shenxiaofeng2019/rail-traffic_prj/Code/版本说明.txt

20200716：上海10台安装
20200803：上海6台安装
20200814：演示代码Z轴演示归零
20200723：演示代码Z轴演示
20200821：演示代码三轴演示
20200915：演示代码增加通讯应答及等待超时机制
