shenxiaofeng2019/rail-traffic_prj/轨交异常数据.docx

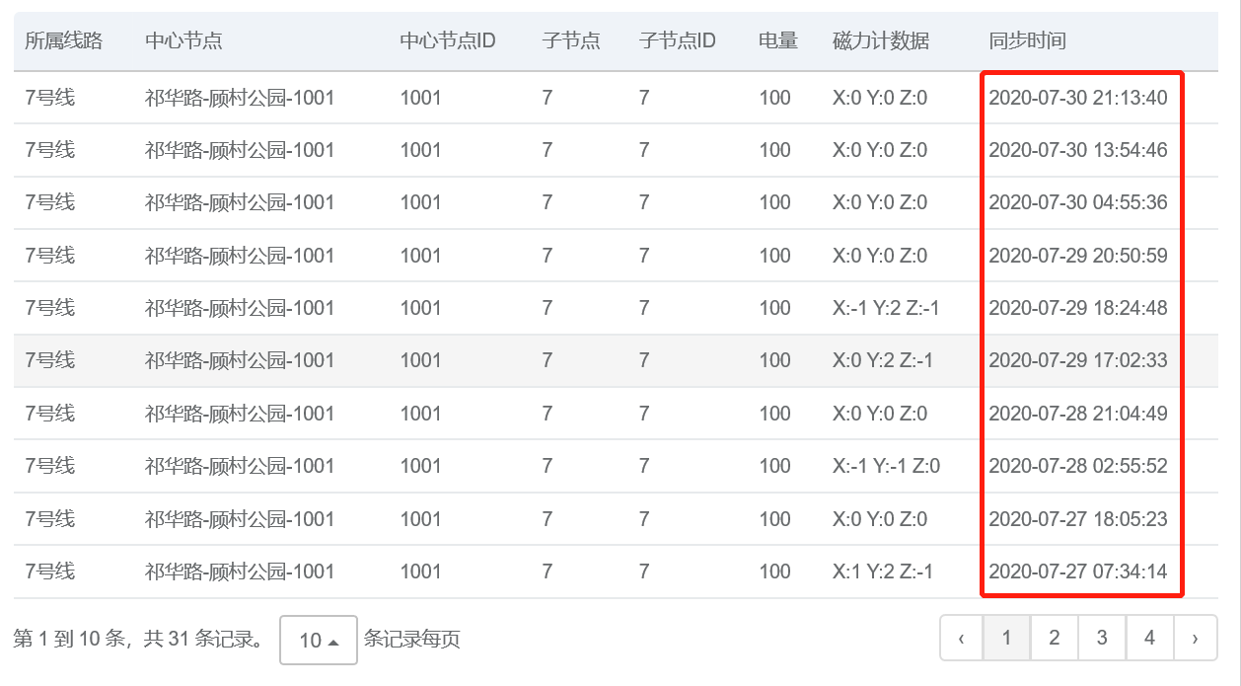
[picture p15: figure]

1001-07 (上报间隔时间有误)

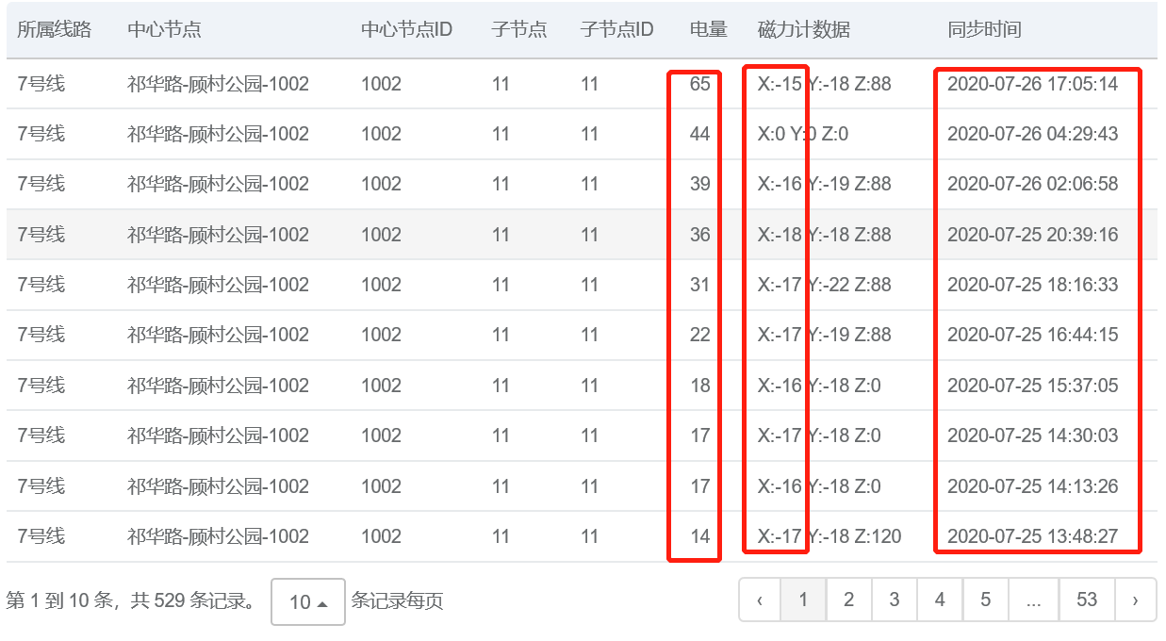
[picture p16: figure]

1002-11 (电量/角度/上报间隔时间)

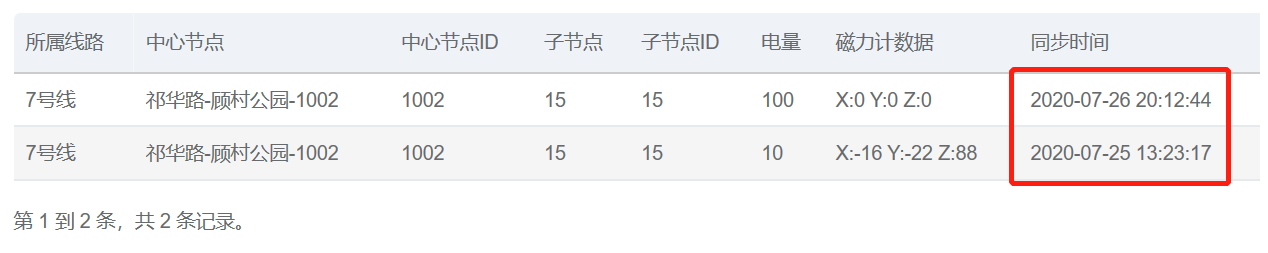
[picture p17: figure]

1002-15 (上报间隔时间有误)

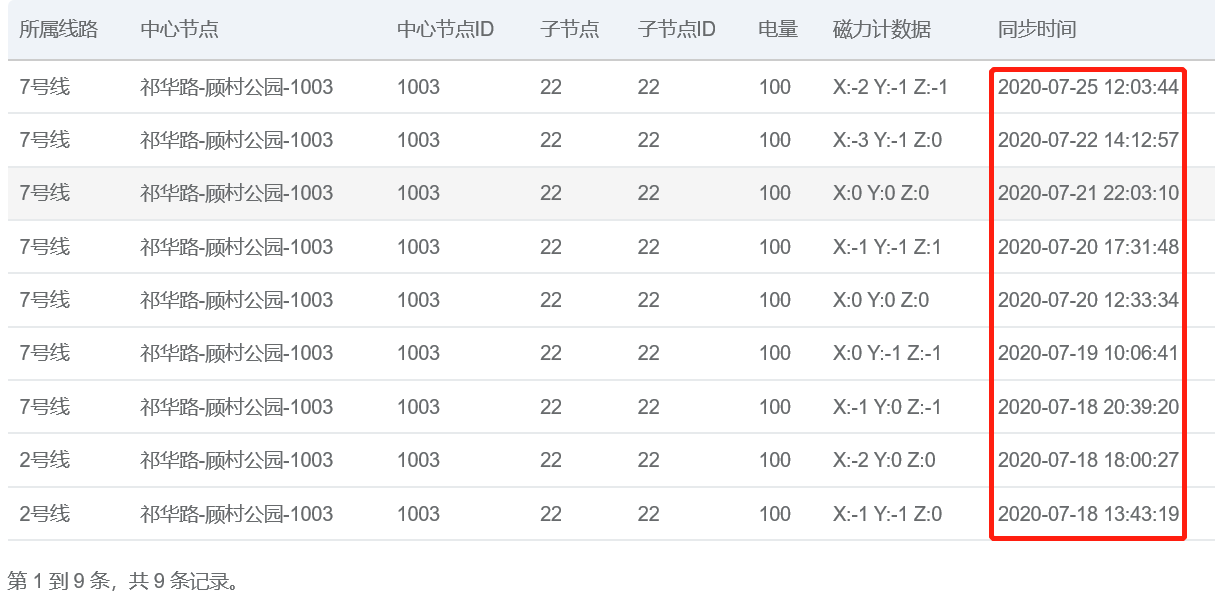
[picture p18: figure]

1003-22 (上报间隔时间有误)
1003-27 (无数据上报)

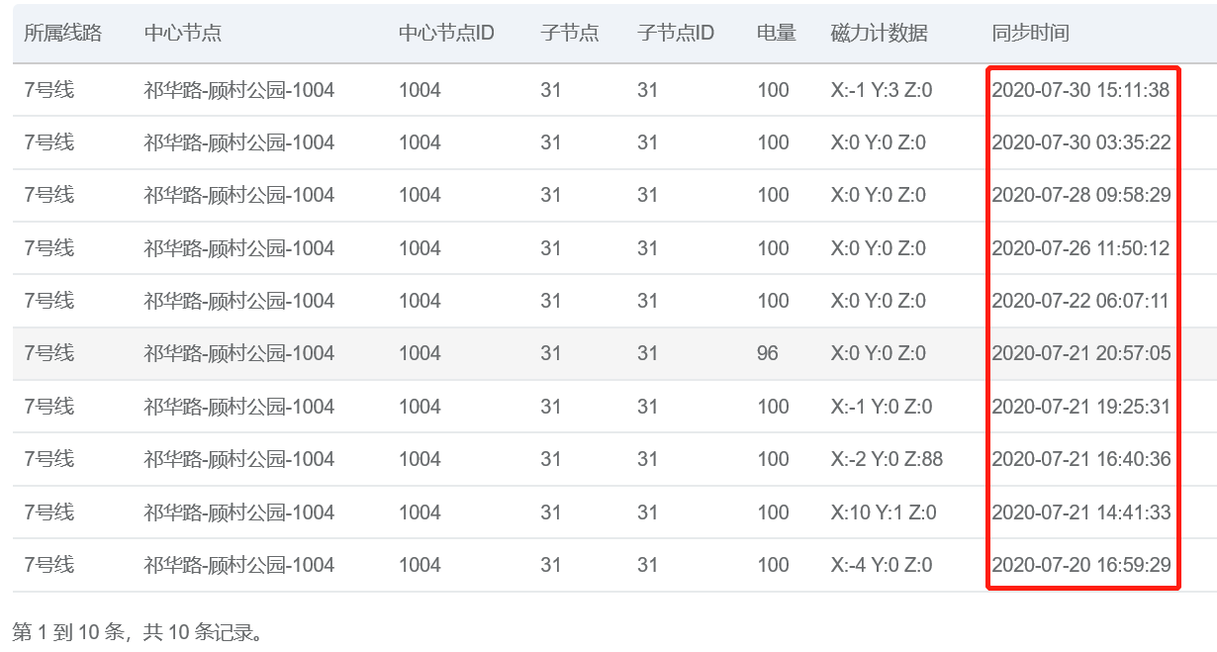
[picture p19: figure]

1004-31 (上报间隔时间有误)

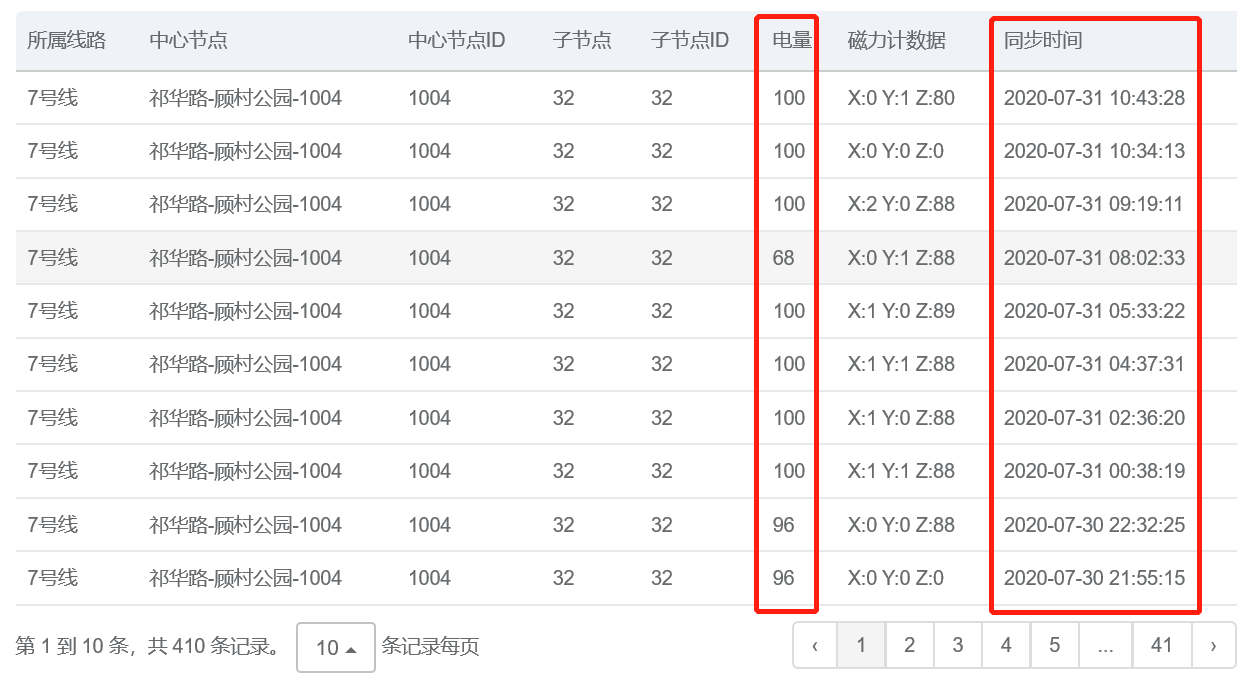
[picture p20: figure]

1004-32 (电量/上报间隔时间有误)
1004-33 (无数据上报)

问题：

1. 上报间隔时间有误
2. 两台电量不准确
3. 两台无数据上报
4. 一台角度有问题

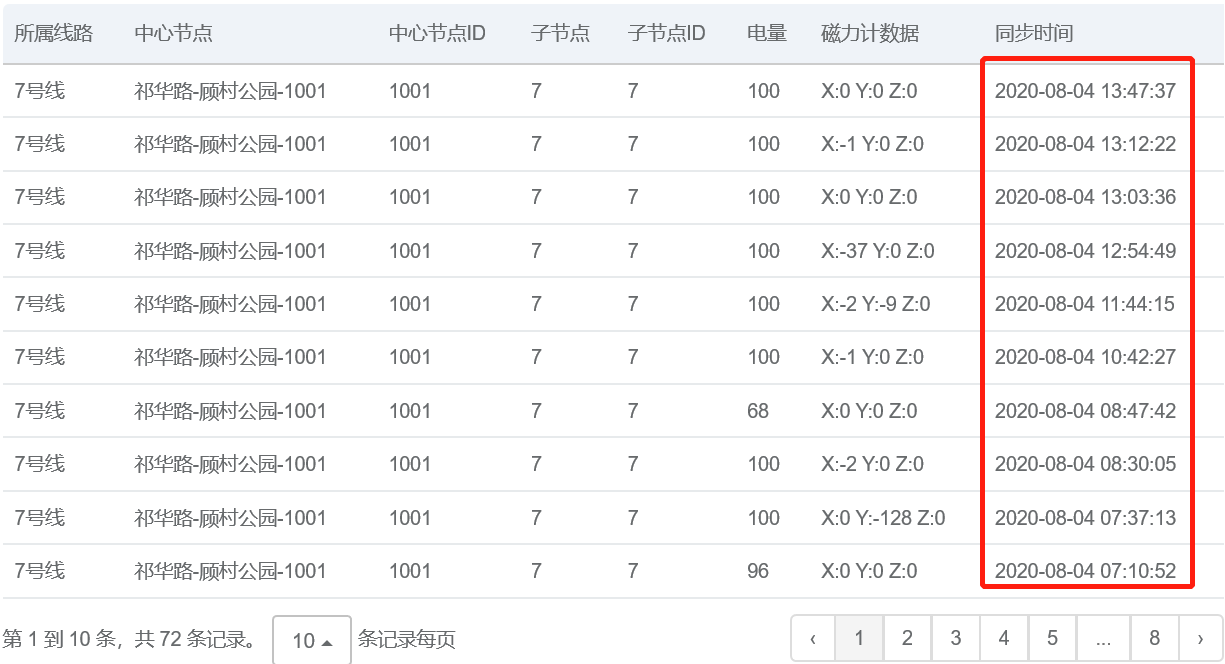
[picture p21: figure]

1001-07 (上报间隔时间有误)

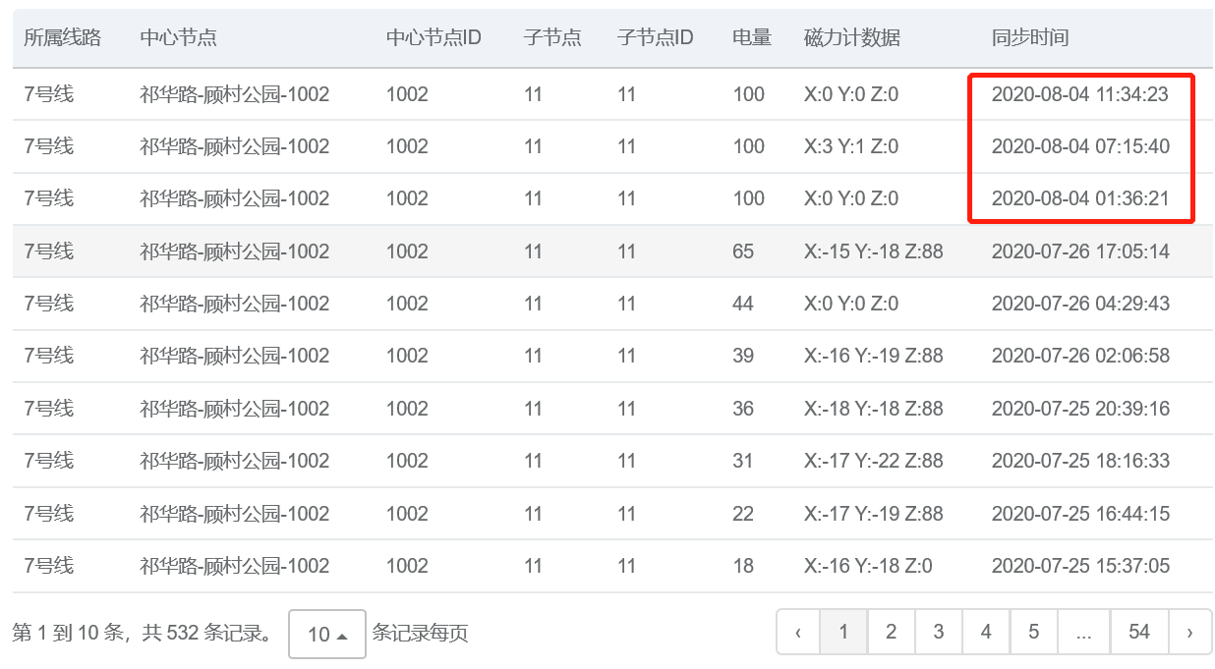
[picture p22: figure]

1002-11 (电量/角度/上报间隔时间)

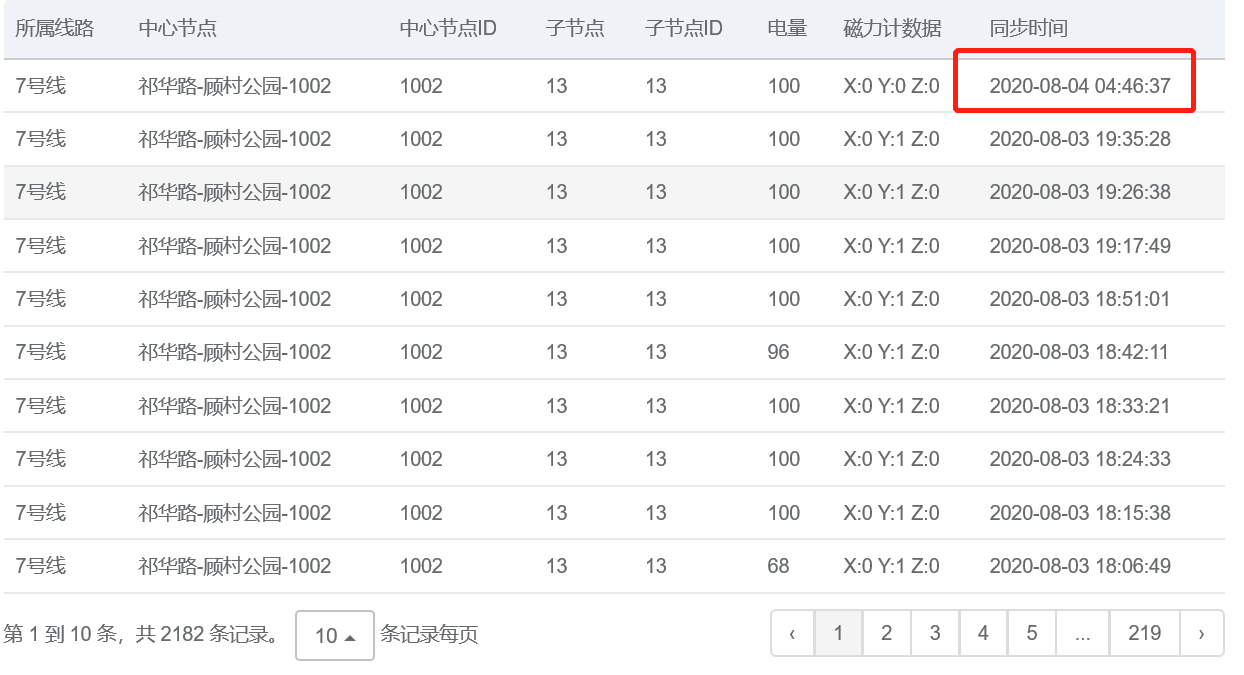
[picture p23: figure]

1002-13 (上报间隔时间有误)
1002-15 (上报间隔时间正常)
1003-22 (上报间隔时间有误)
1003-27 (无数据上报)

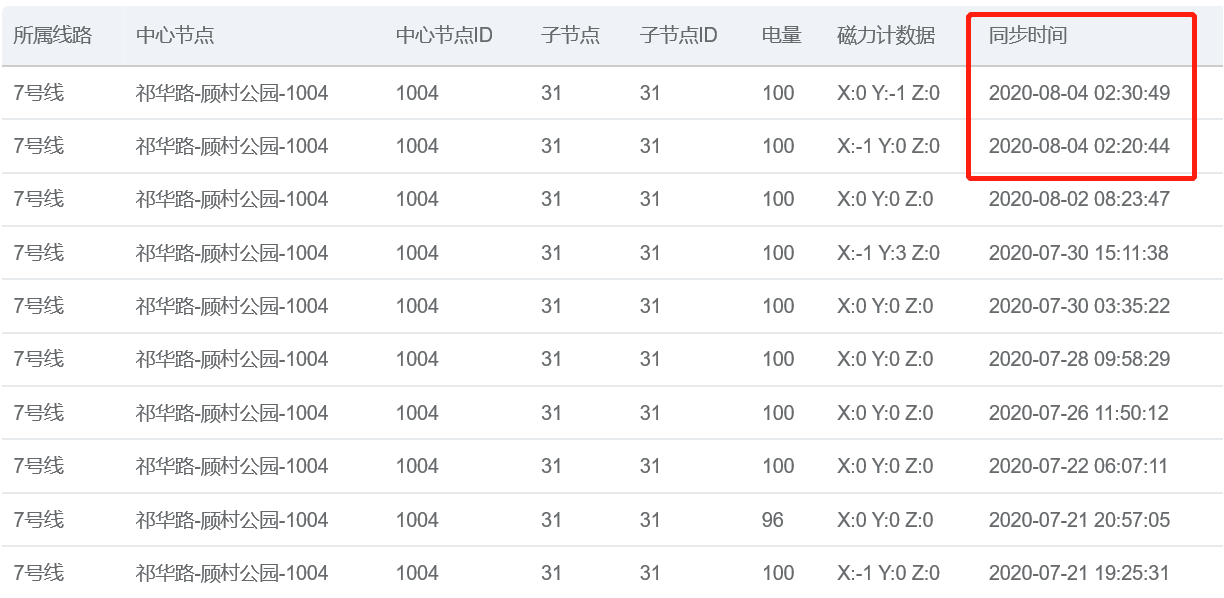
[picture p24: figure]

1004-31 (上报间隔时间有误)
1004-32 (电量/上报间隔时间正常)
1004-33 (有数据上报)
