shenxiaofeng2019/rail-traffic_prj/Protocol/微信图片_20200803155351.png

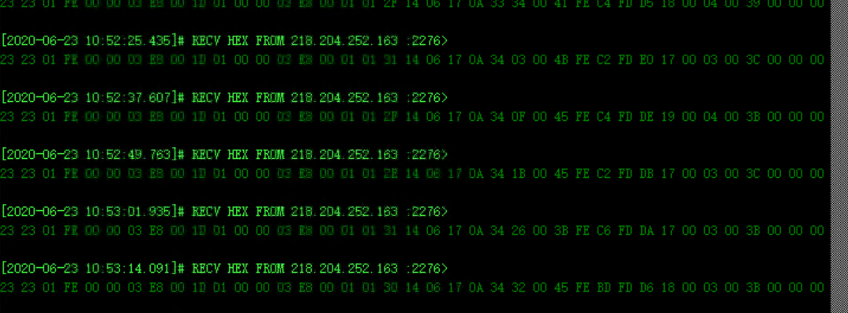
Protocol/微信图片_20200803155351.png
