shenxiaofeng2019/rail-traffic_prj/Protocol/微信图片_20200803155401.png

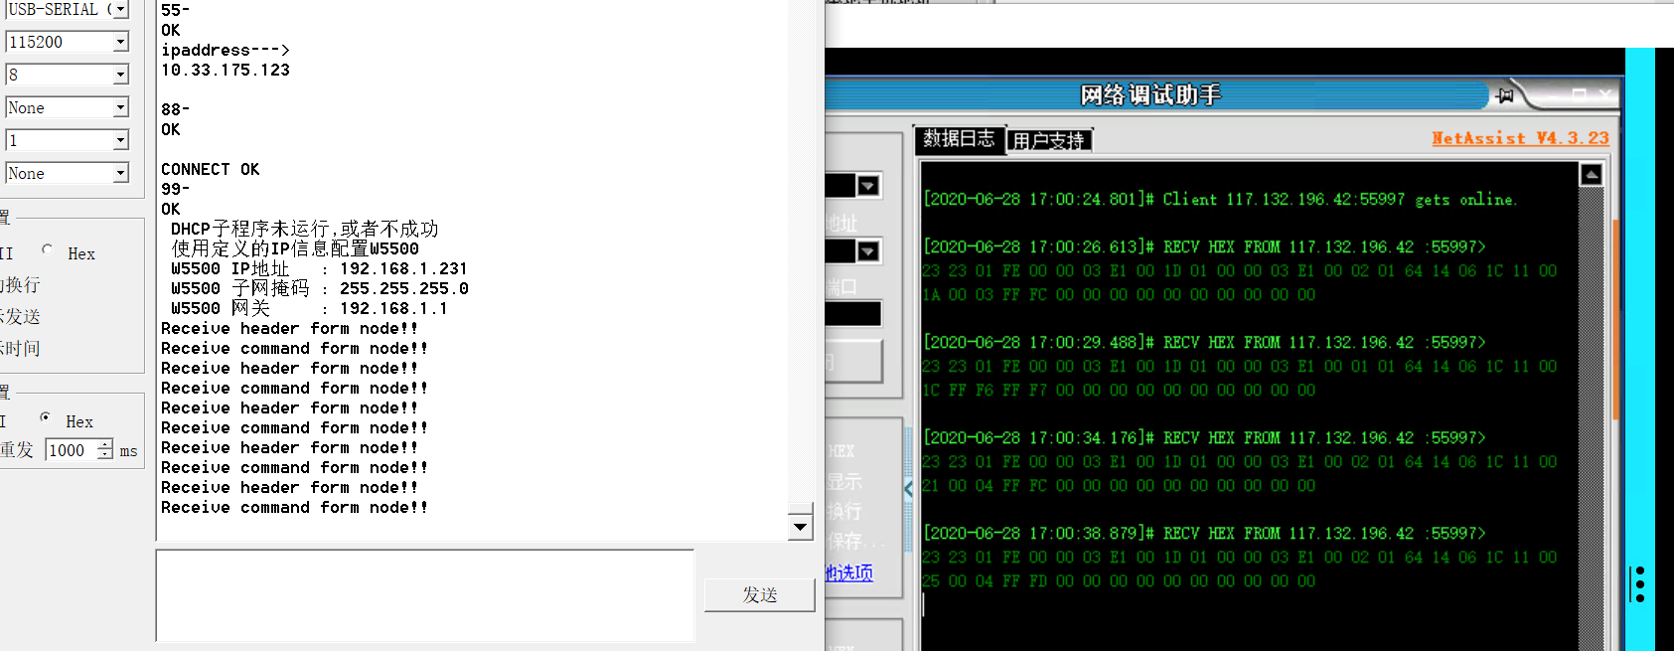
Protocol/微信图片_20200803155401.png
