shenxiaofeng2019/rail-traffic_prj/Test/1002.png

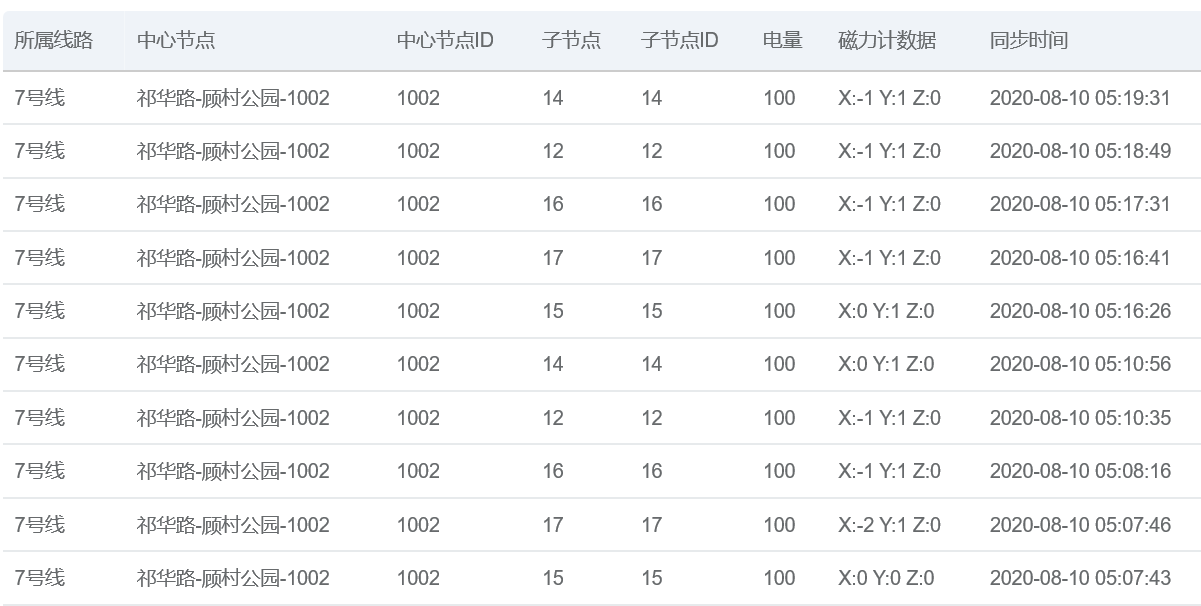
Test/1002.png
