shenxiaofeng2019/rail-traffic_prj/Test/1004.png

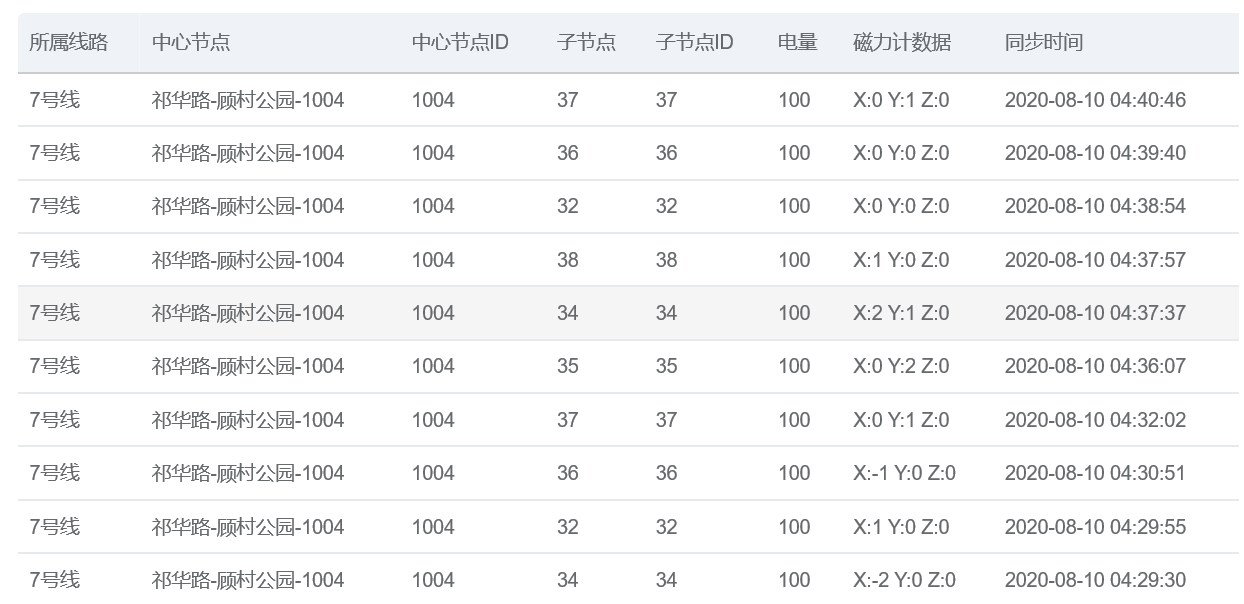
Test/1004.png
