shenxiaofeng2019/rail-traffic_prj/硬件调试修改点.txt

1.R42由100K改为1K
2.R5 R7需焊接47欧姆电阻
3.电源检测分一路经隔离后分压送AD
4.天线
5.干簧管
6.MPU9250
