shenxiaofeng2019/rail-traffic_prj/Ref/obdii_bottom_ver2_20181116.pdf

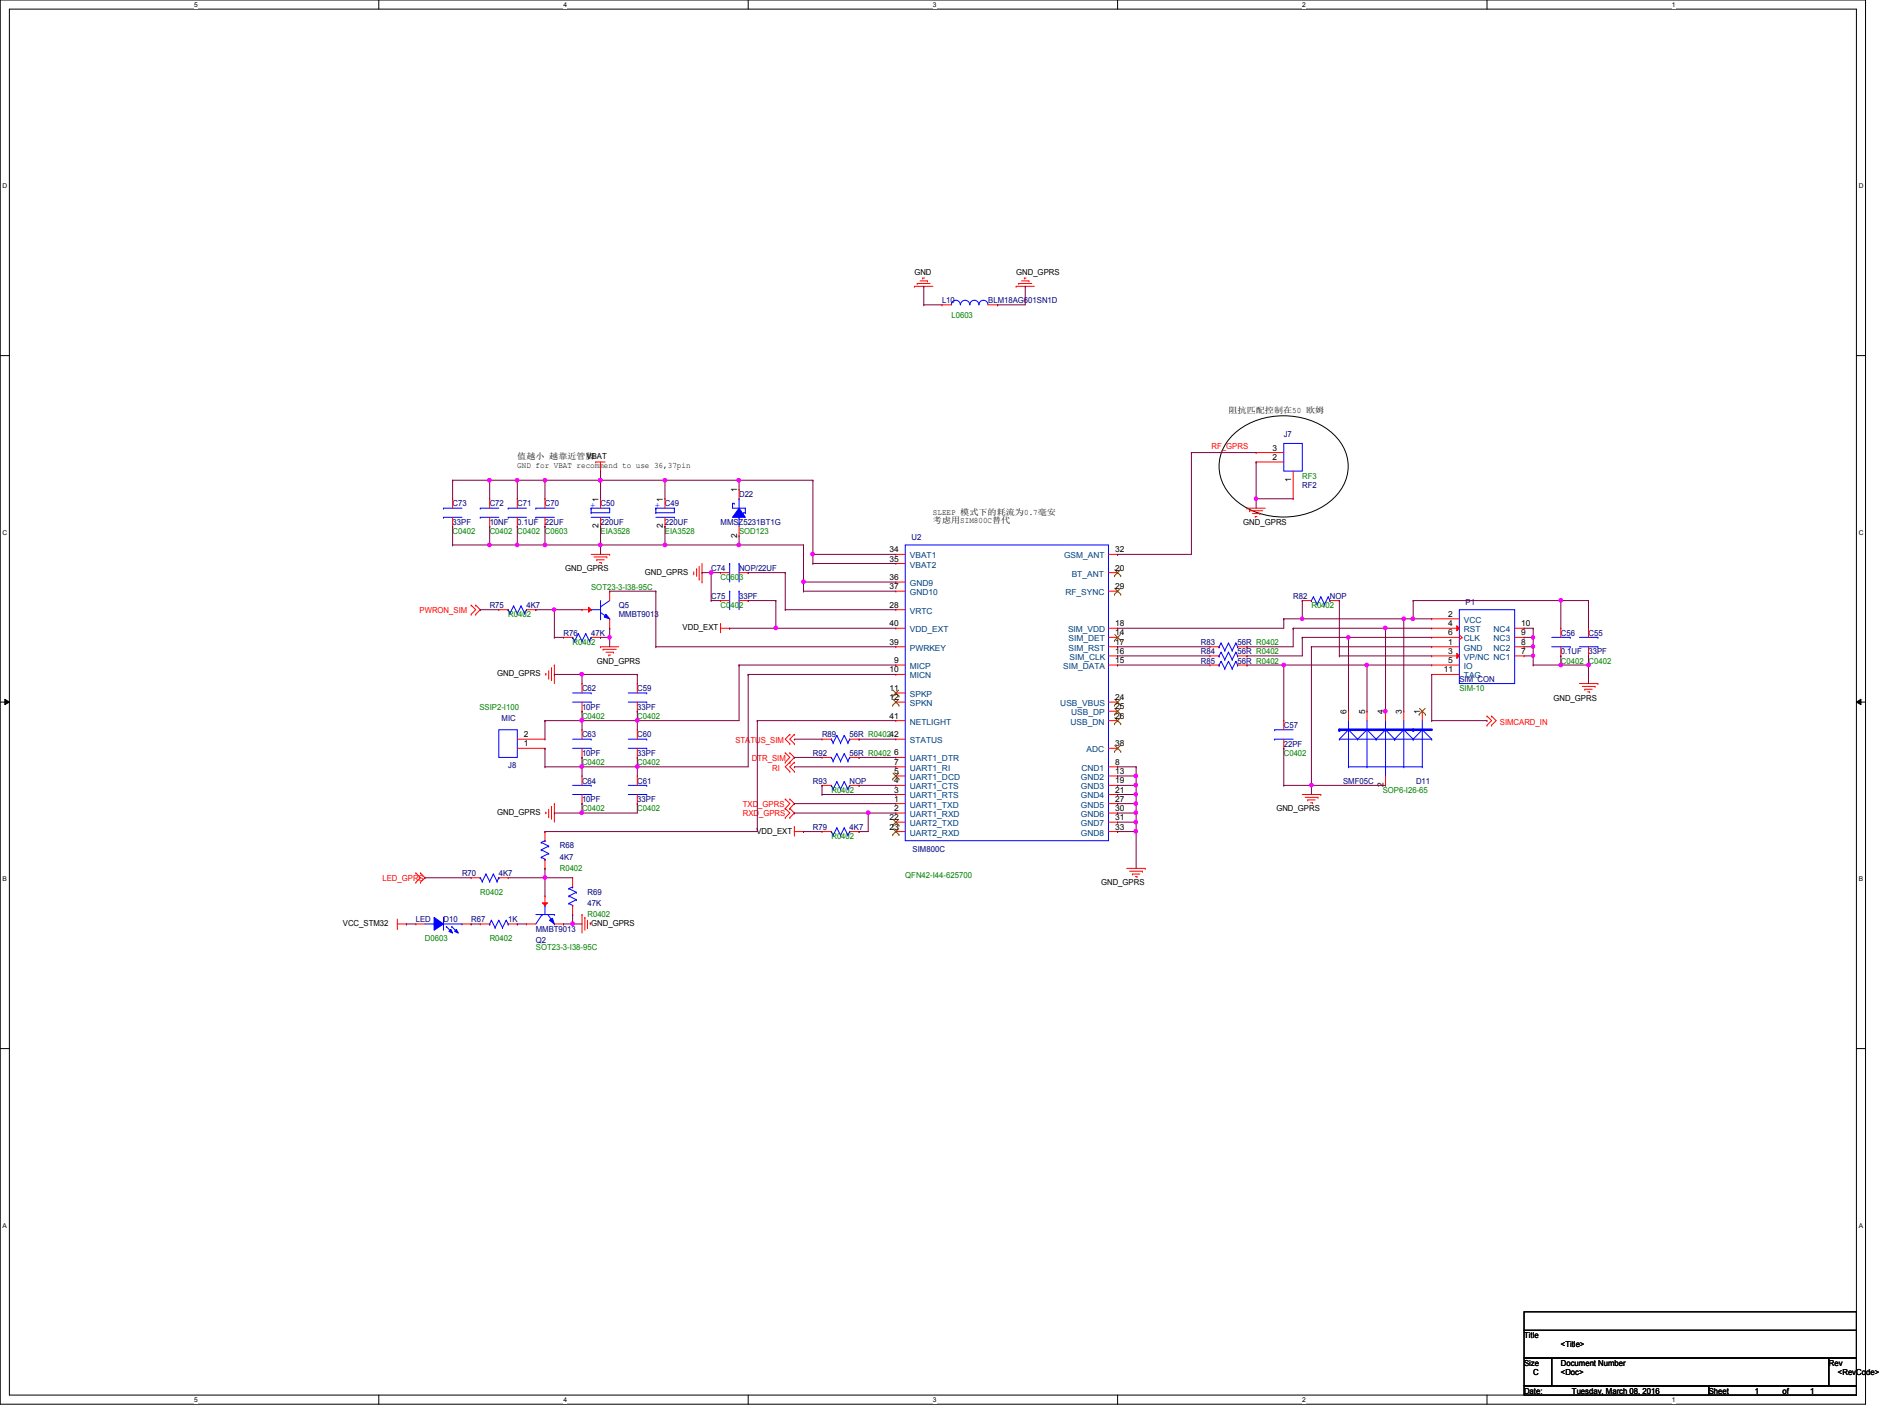
[picture p35: page 1]

值值值 值越越越越
GND for VBAT recommend to use 36,37pin

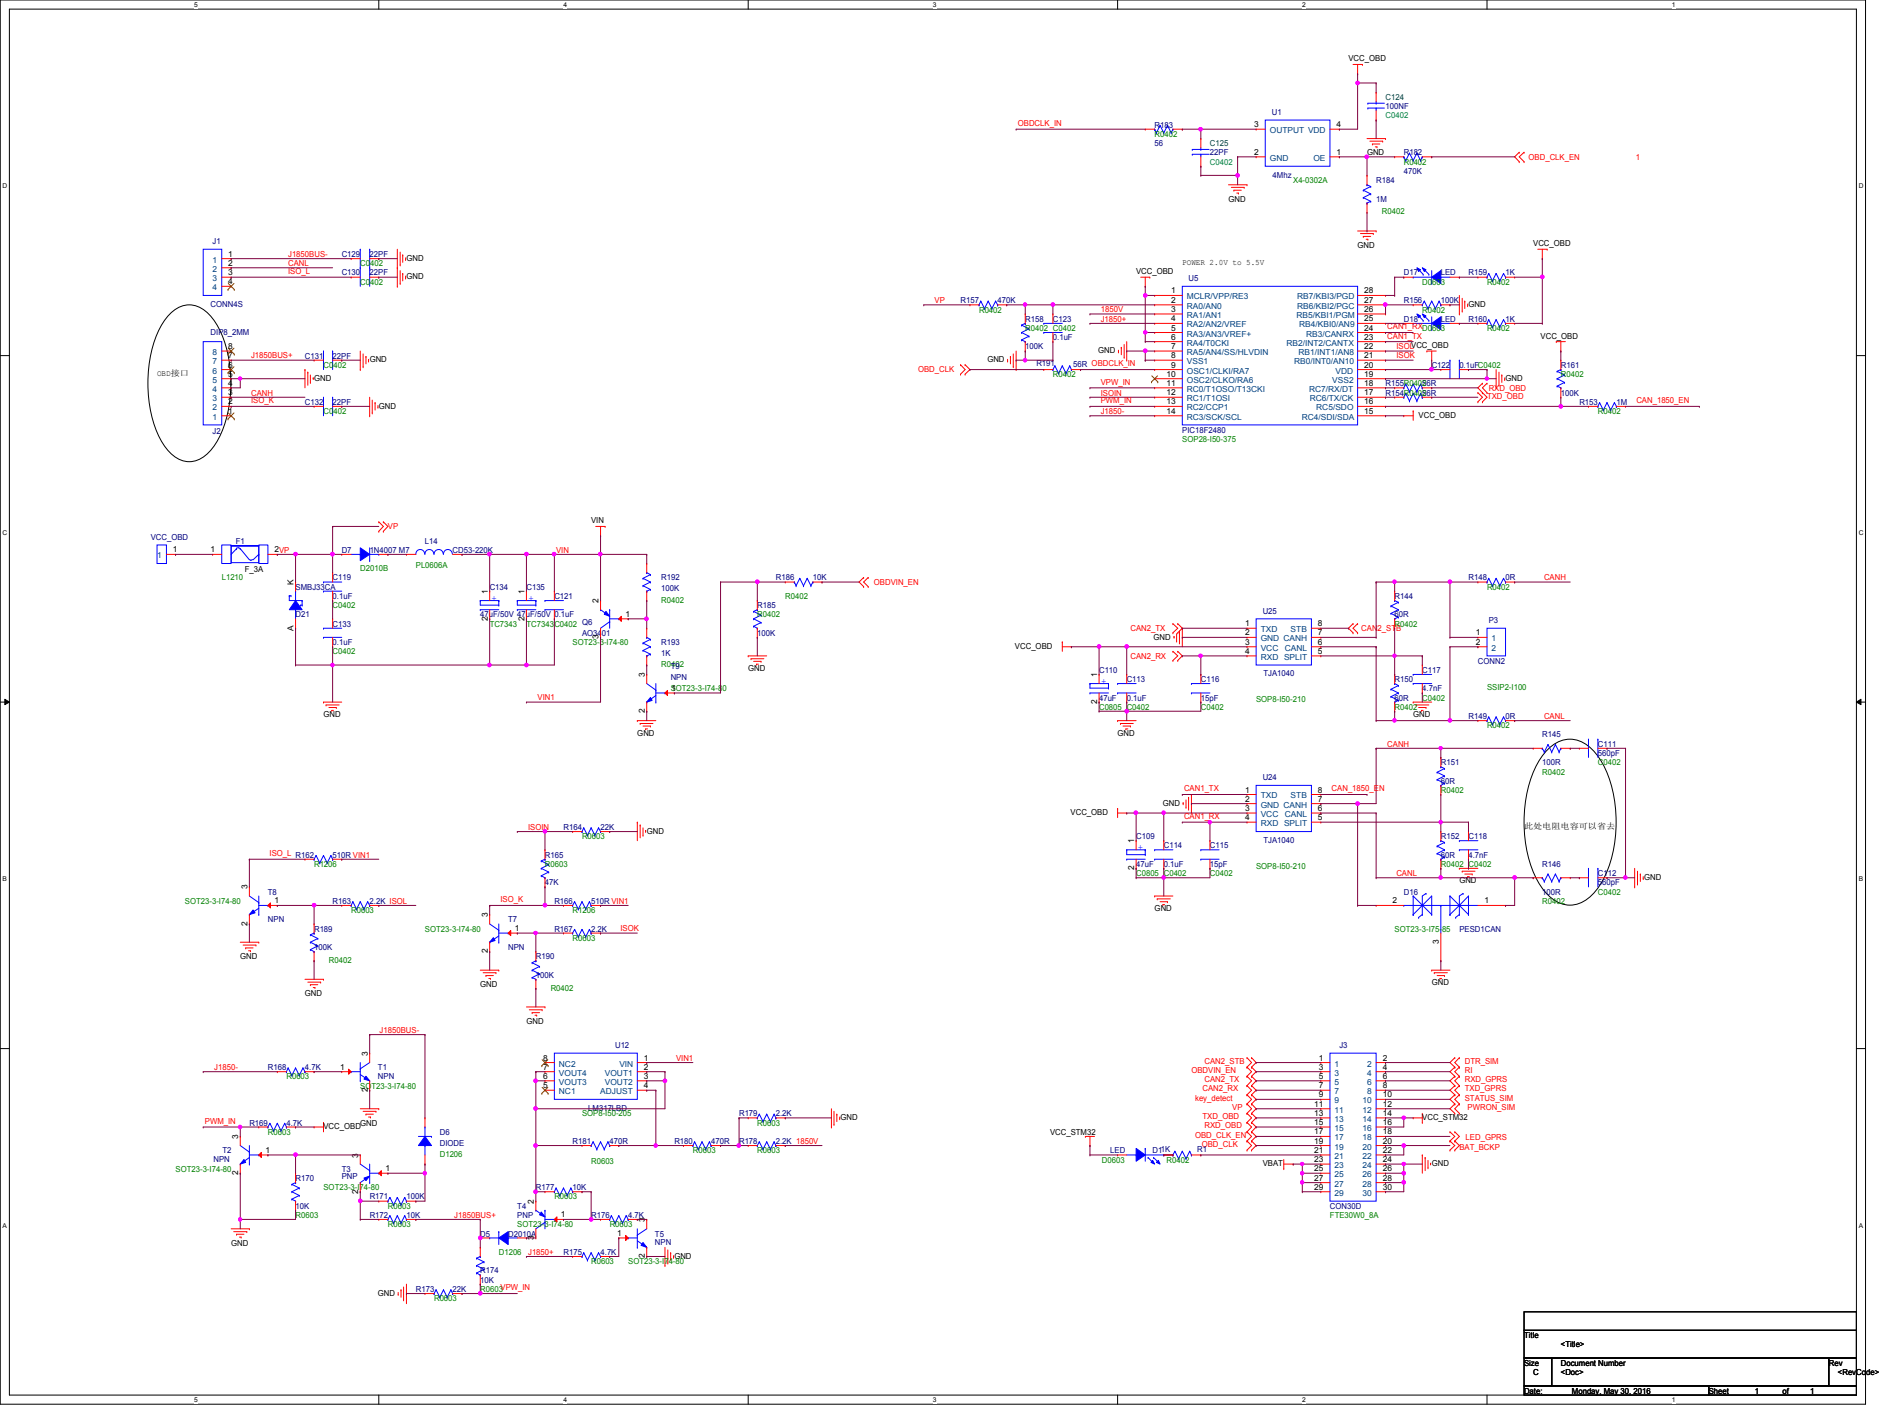
[picture p36: page 2]

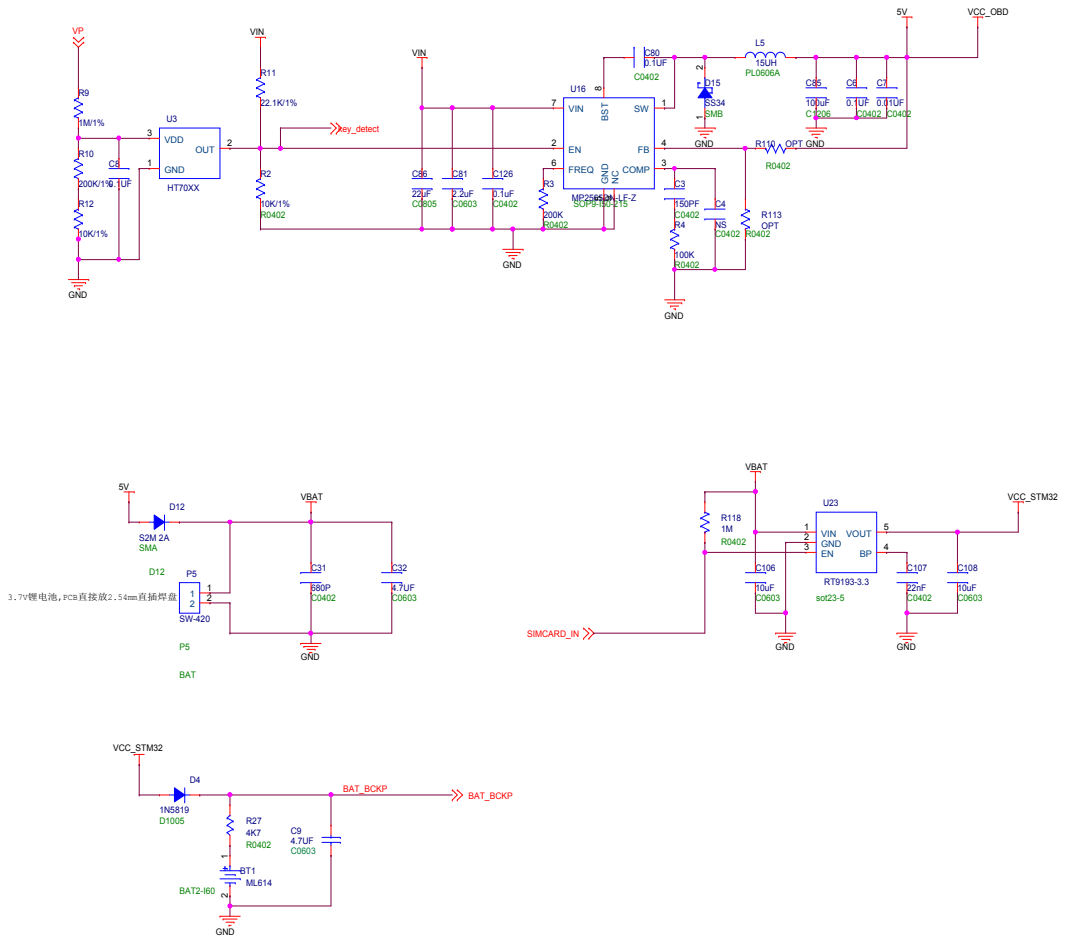
[picture p37: page 3]
