shenxiaofeng2019/rail-traffic_prj/原理/cellect.pdf

# 47K U18 HT7325 SOT89-4-I60-95A GND

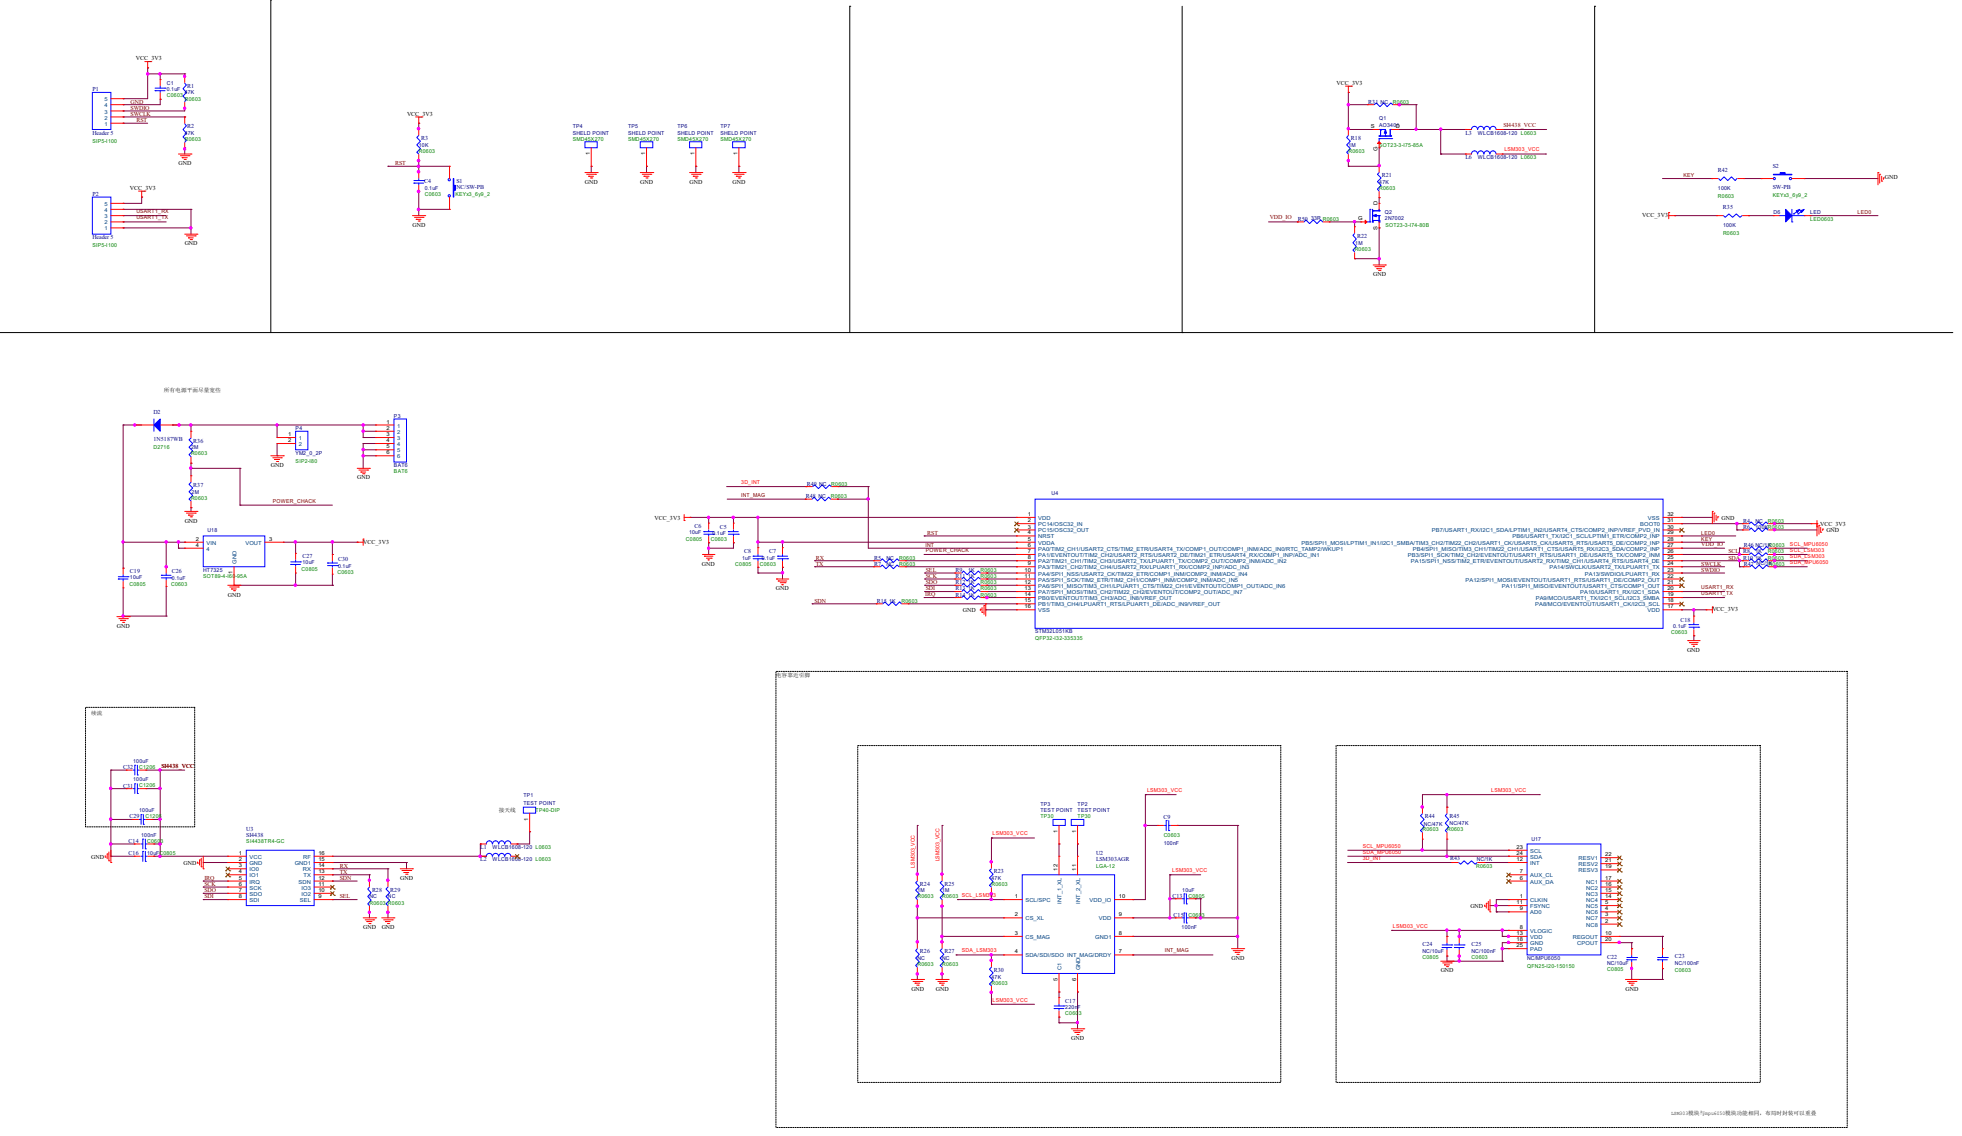
[picture p38: page 1]
