shenxiaofeng2019/rail-traffic_prj/原理/CEN.pdf

# STM32F1

si4438

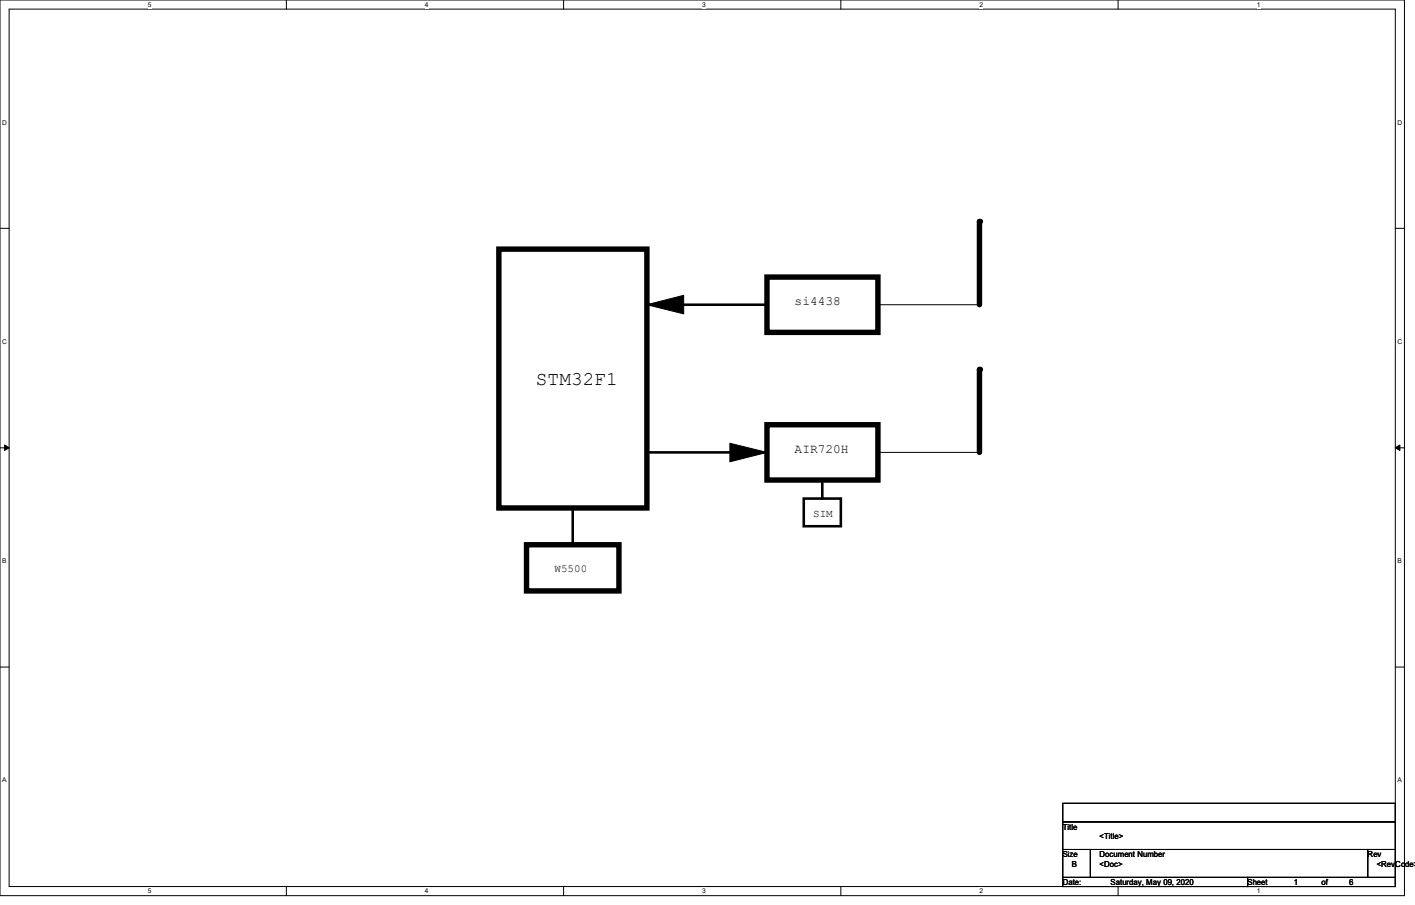
[picture p39: page 1]
AIR720H; SIM; Title Size; Document Number; Rev Date:; Sheet; of <Doc>; <RevCode>; <Title> B; Saturday, May 09, 2020; 6 Title Size

5V/2A

# VDD3V3 VDD3V3

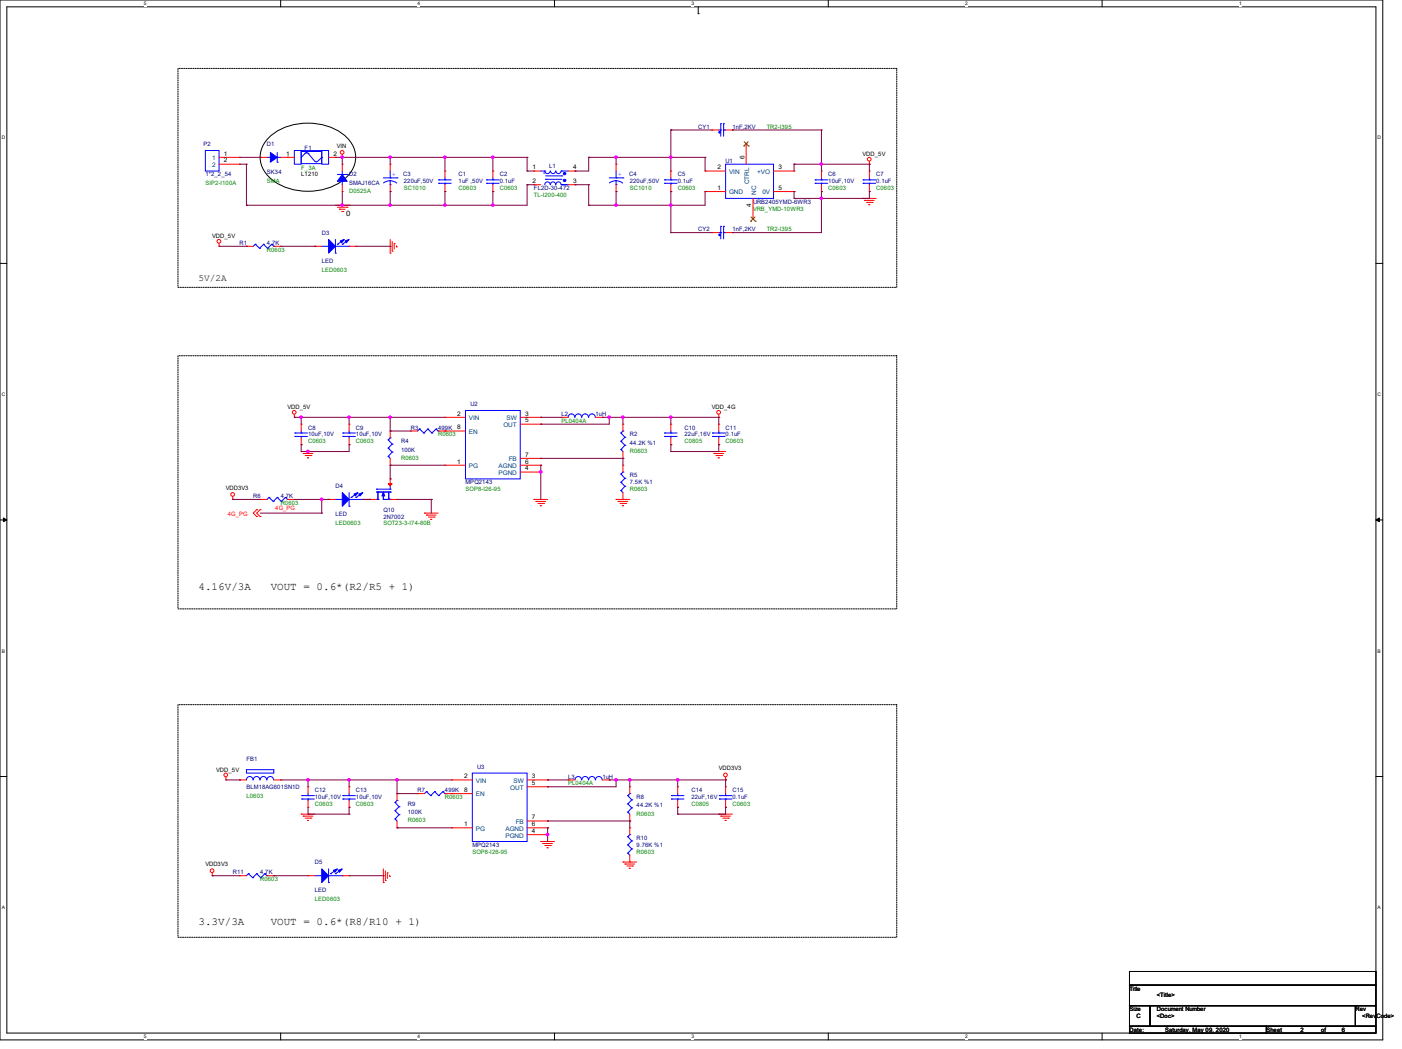
[picture p40: page 2]

22uF,16V C0805 U2 MPQ2143 SOP8-I26-95 PG 1 VIN
2 SW 3 PGND 4 OUT 5 AGND 6 FB

# FLASH

ISP | SD CARD BOOT

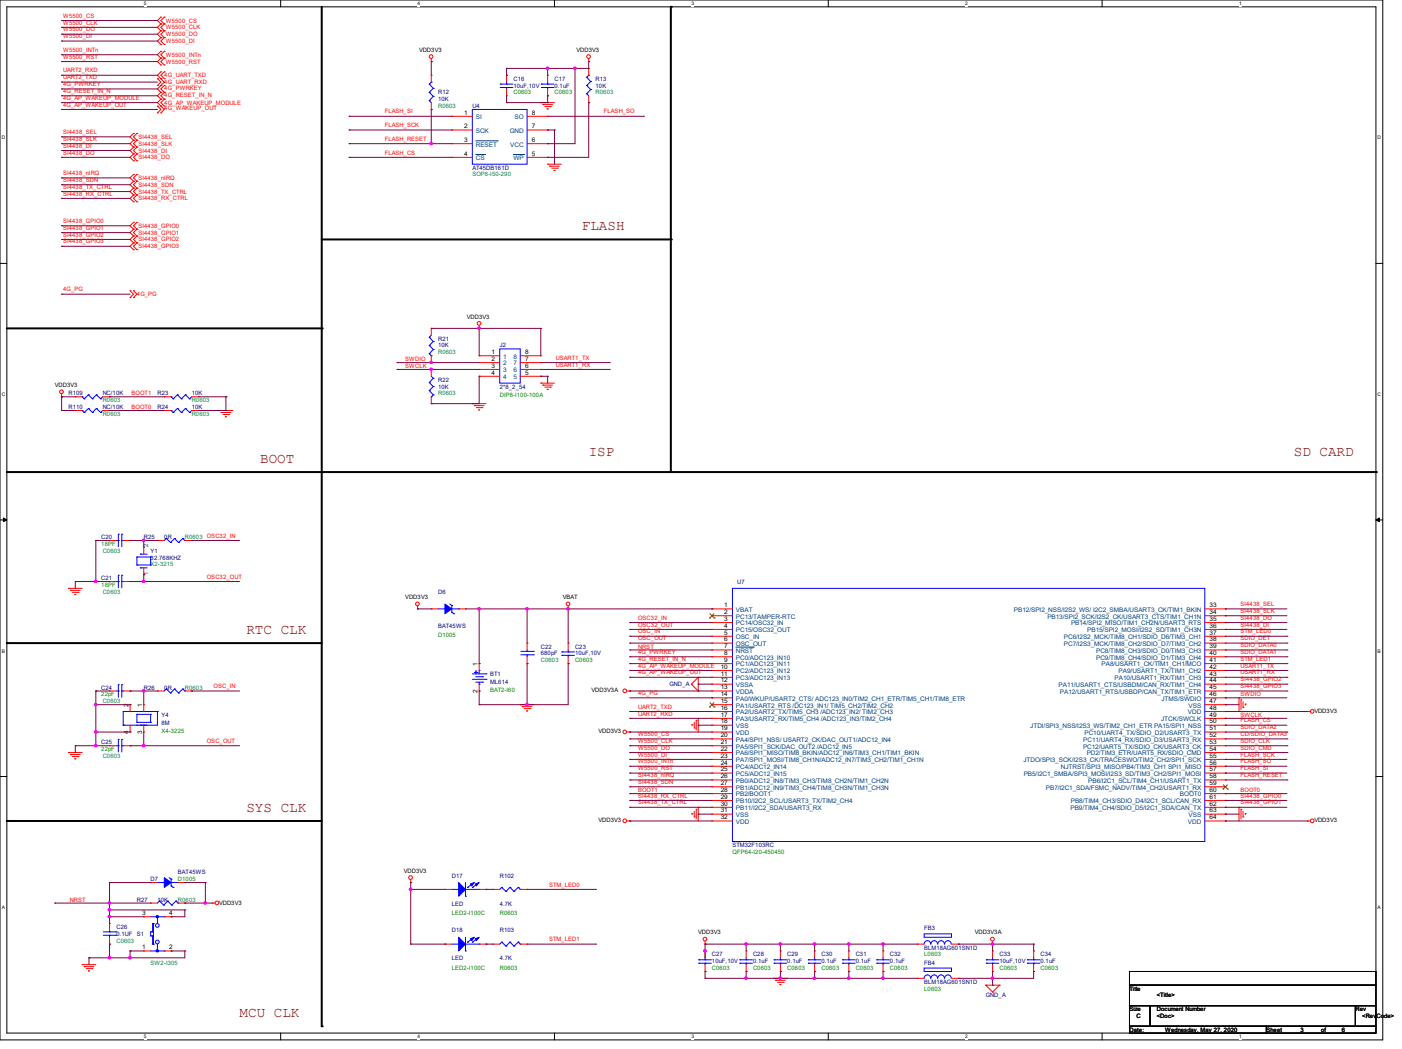
[picture p41: page 3]

1 PC13/TAMPER-RTC 2 PC14/OSC32_IN 3 PC15/OSC32_OUT 4 OSC_IN 5 OSC_OUT 6 NRST 7 PC0/ADC123_IN10 8 PC1/ADC123_IN11 9 PC2/ADC123_IN12 10 PC3/ADC123_IN13 11 VSSA 12 VDDA

JTMS/SWDIO 46 VSS 47 VDD

JTDO/SPI3_SCK/I2S3_CK/TRACESWO/TIM2_CH2/SPI1_SCK 55 NJTRST/SPI3_MISO/PB4/TIM3_CH1 SPI1_MISO 56 PB5/I2C1_SMBA/SPI3_MOSI/I2S3_SD/TIM3_CH2/SPI1_MOSI 57 PB6/I2C1_SCL/TIM4_CH1/USART1_TX 58 PB7/I2C1_SDA/FSMC_NADV/TIM4_CH2/USART1_RX 59 BOOT0 60 PB8/TIM4_CH3/SDIO_D4/I2C1_SCL/CAN_RX 61 PB9/TIM4_CH4/SDIO_D5/I2C1_SDA/CAN_TX 62 VSS 63 VDD

SYS CLK

D7 BAT45WS D1005 4 MCU CLK

# Power on & Reset

# SIM CARD

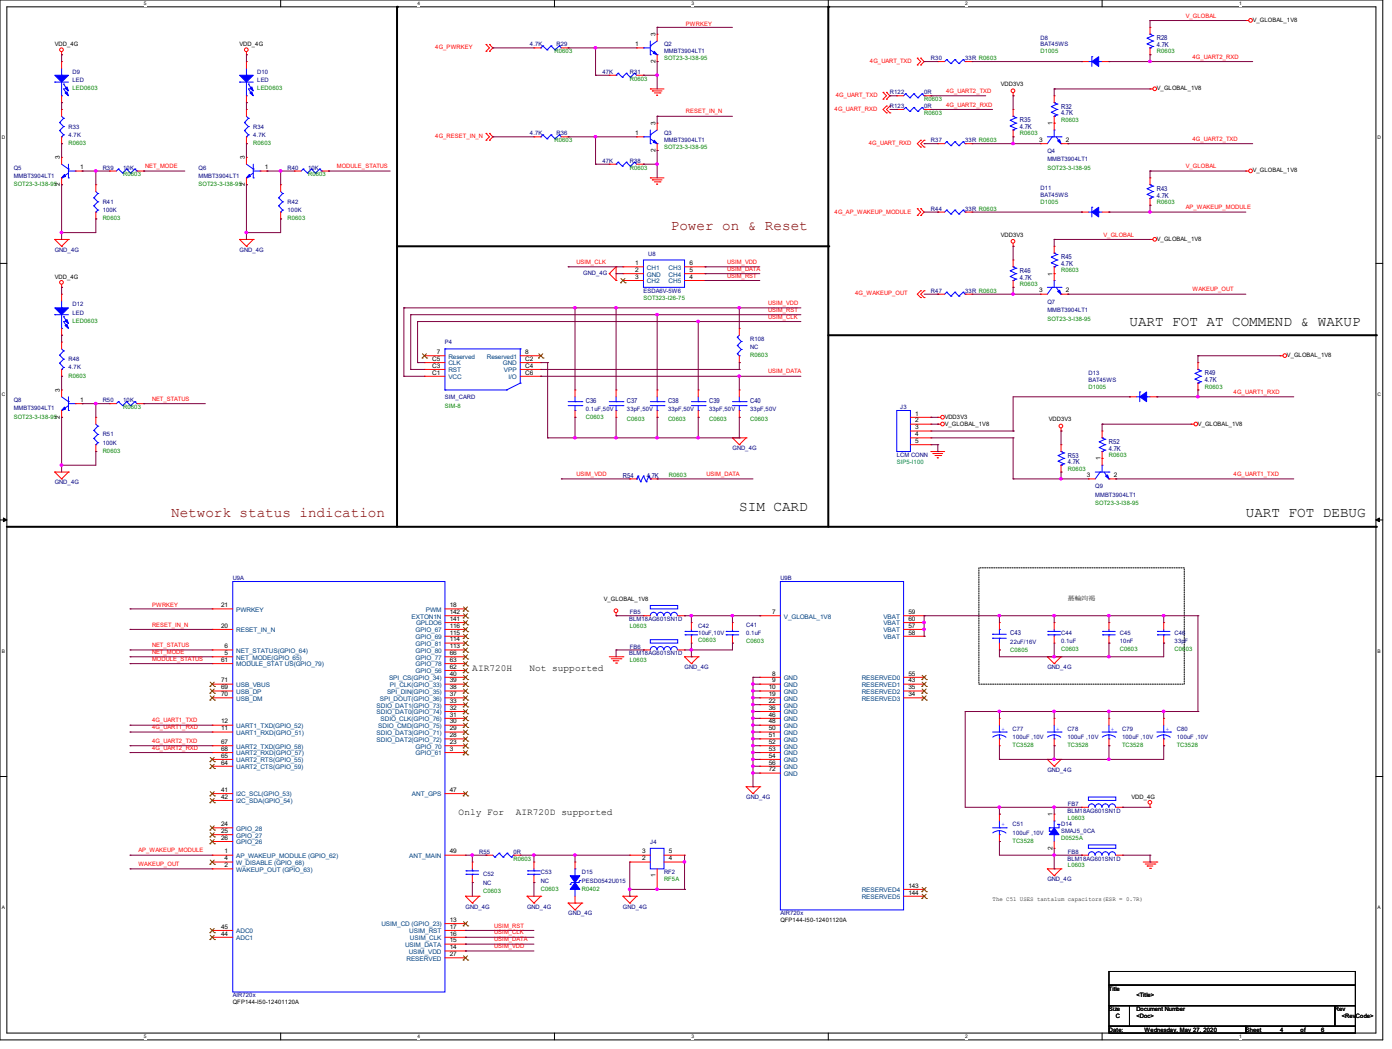
[picture p42: page 4]

UART FOT AT COMMEND & WAKUP

VDD3V3_SI4438 | VDD3V3 GND_RF | GND_RF | GND_RF | GND_RF GND_RF GND_RF | GND_RF GND_RF | GND_RF GND_RF

## SI4438_DO

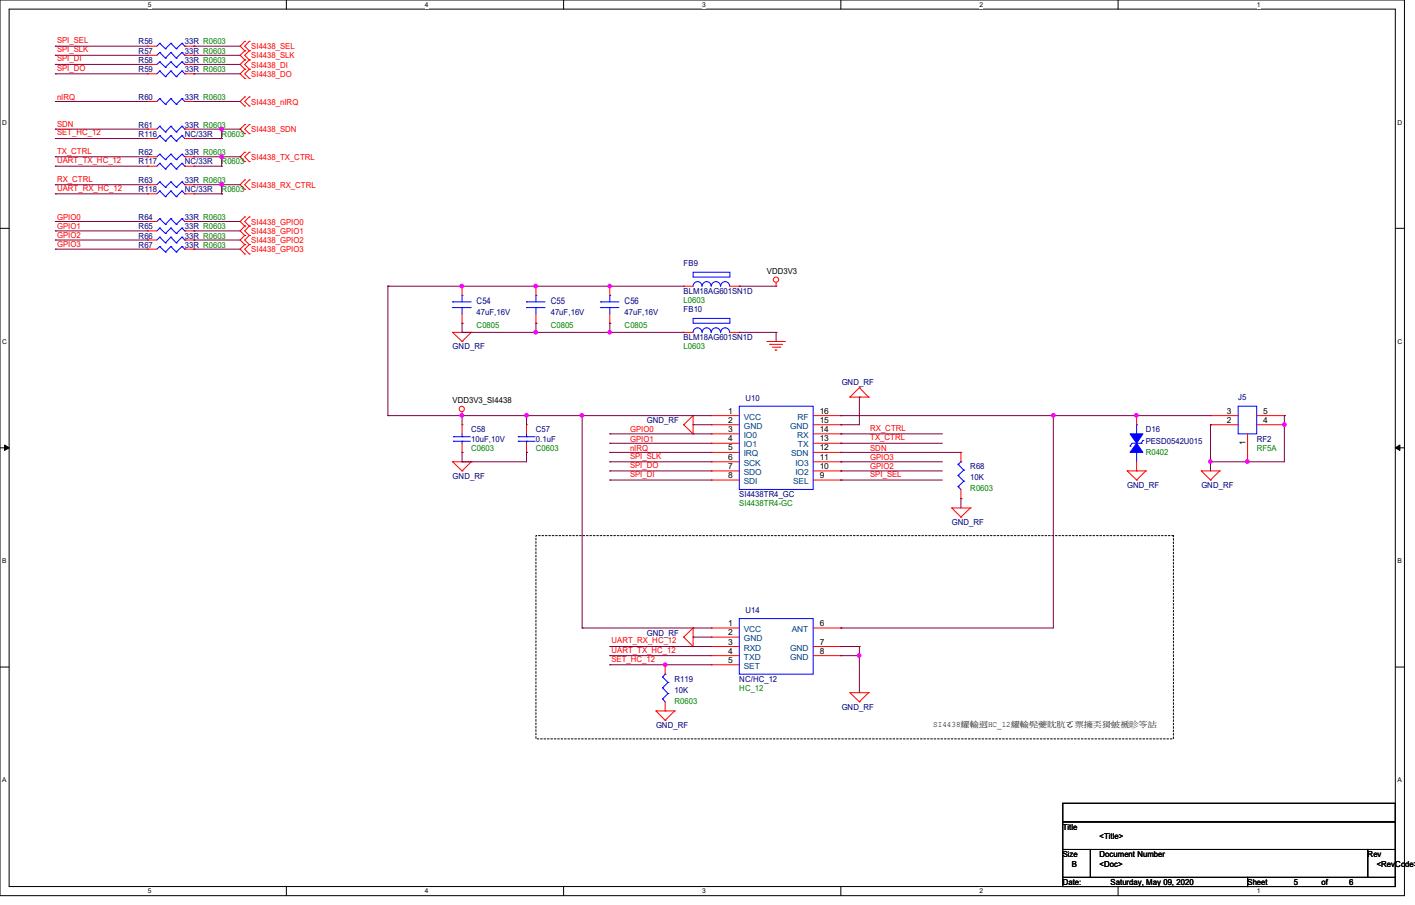
[picture p43: page 5]

# 111 ALL CAPABLE,AUTO-NEGOTIATION ENABLED VDD3V3

# R76 33R R0603 C59

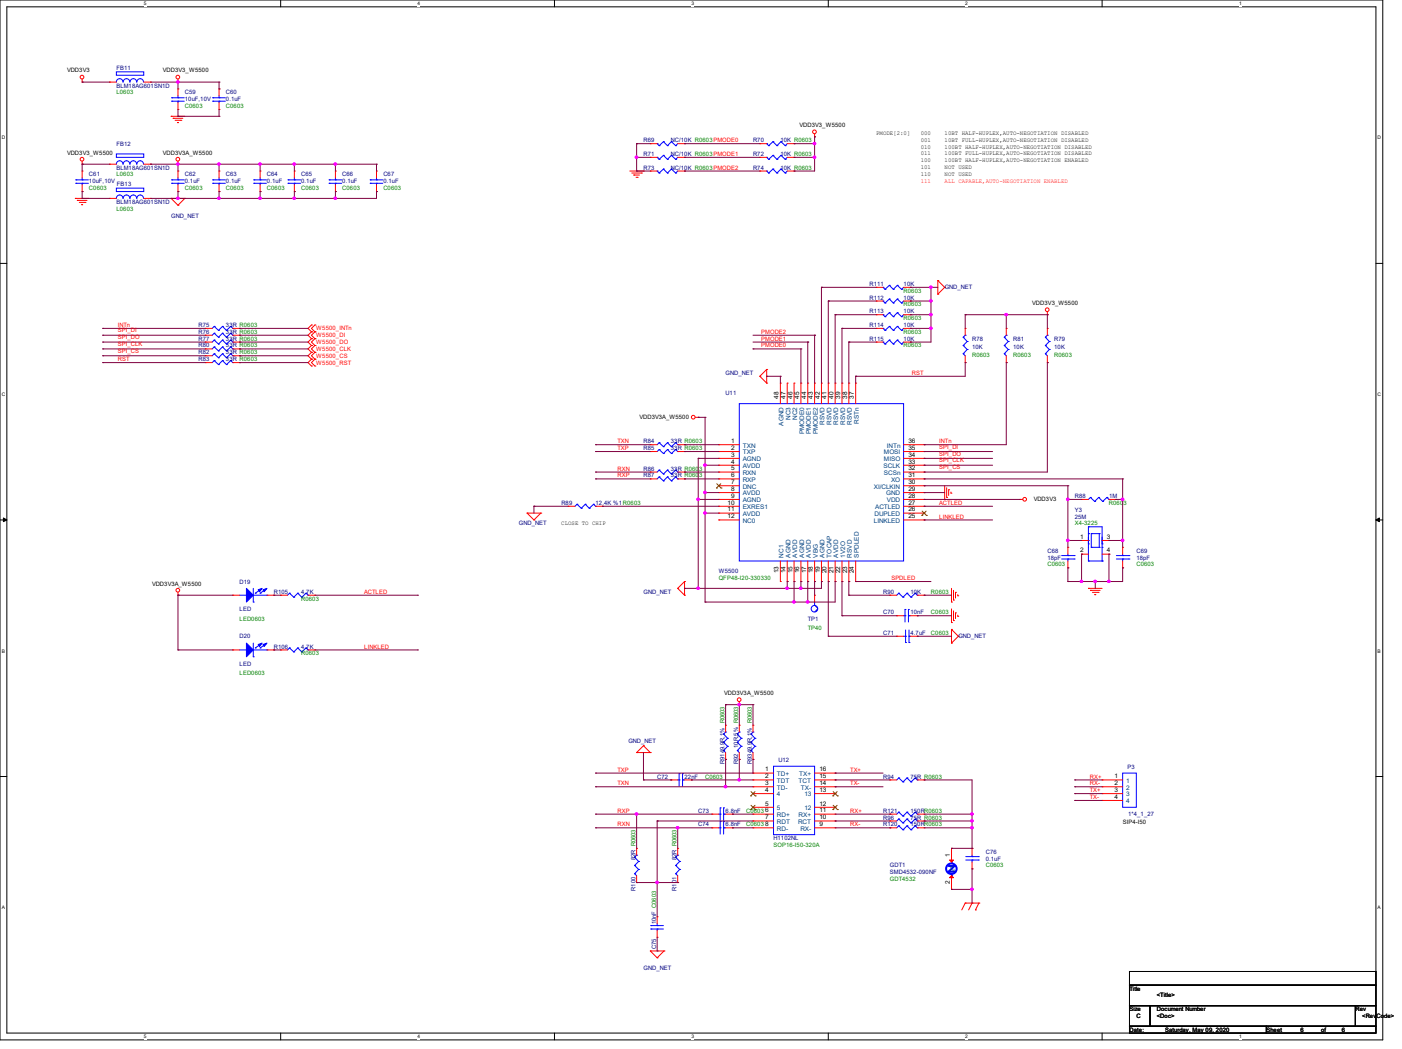
[picture p44: page 6]

001 10BT FULL-HUPLEX,AUTO-NEGOTIATION DISABLED
010 100BT HALF-HUPLEX,AUTO-NEGOTIATION DISABLED
011 100BT FULL-HUPLEX,AUTO-NEGOTIATION DISABLED
100 100BT HALF-HUPLEX,AUTO-NEGOTIATION ENABLED
101 NOT USED
110 NOT USED

25 AGND ⁴⁸ NC³ ⁴⁷ NC² ⁴⁶ PMODE⁰ ⁴⁵ PMODE¹ ⁴⁴ PMODE² ⁴³ RSVD ⁴² RSVD ⁴¹ RSVD ⁴⁰ RSVD ³⁹ RSVD ³⁸ RSTn 37

1 TXP
2 AGND 3 AVDD 4 RXN 5 RXP

36 MOSI 35 MISO 34 SCLK 33 SCSn 32 XO 31 XI/CLKIN 30 GND 29 VDD
INTn

6 DNC 7 AVDD 8 AGND 9 EXRES1 10 AVDD
