shenxiaofeng2019/rail-traffic_prj/Ref/obdii_top_ver2_20181116.pdf

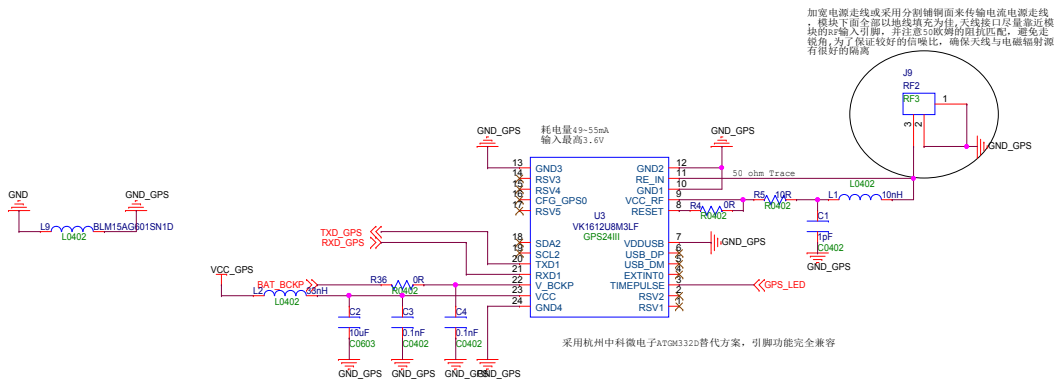
[picture p45: page 1]

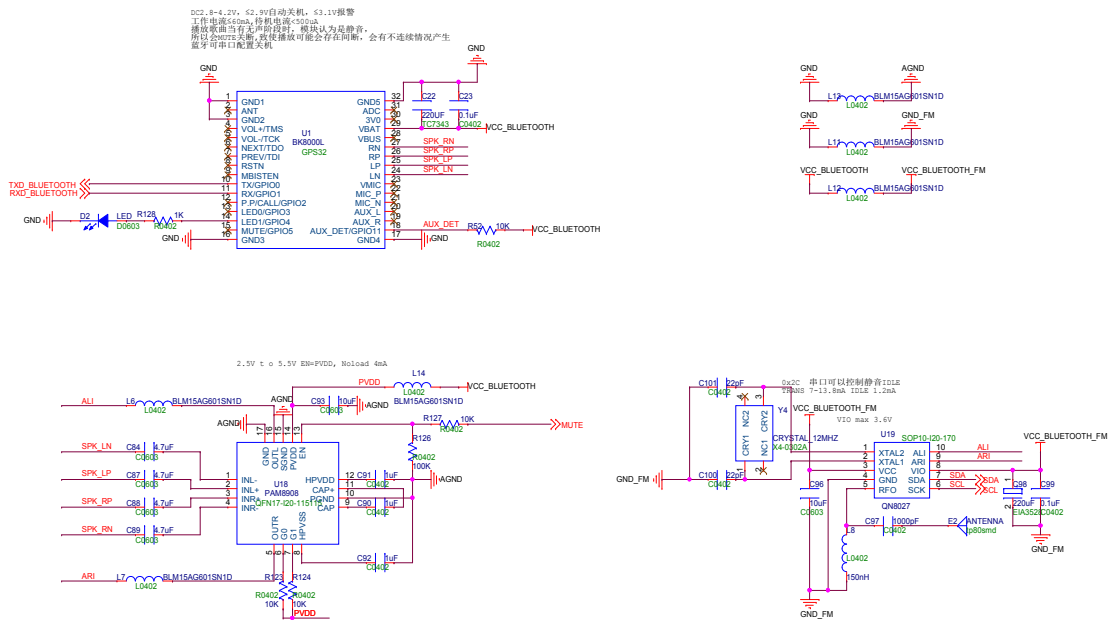
[picture p46: page 2]

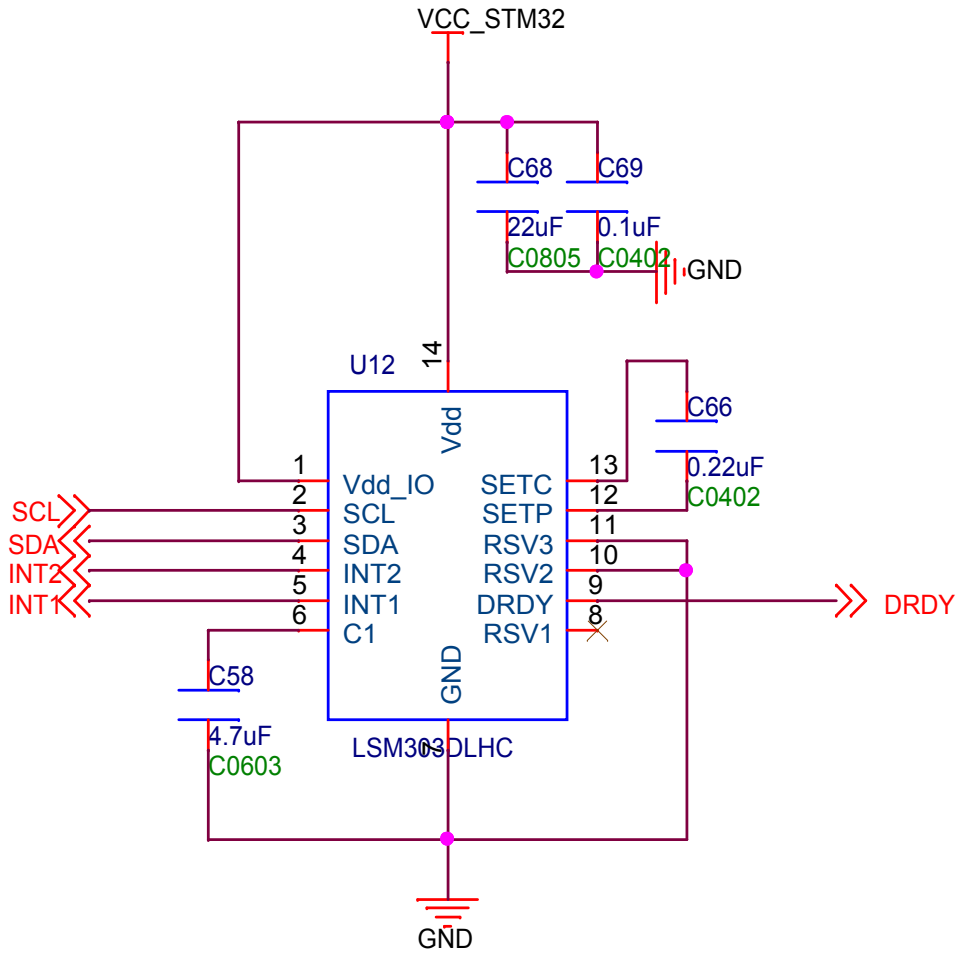
[picture p47: page 3]

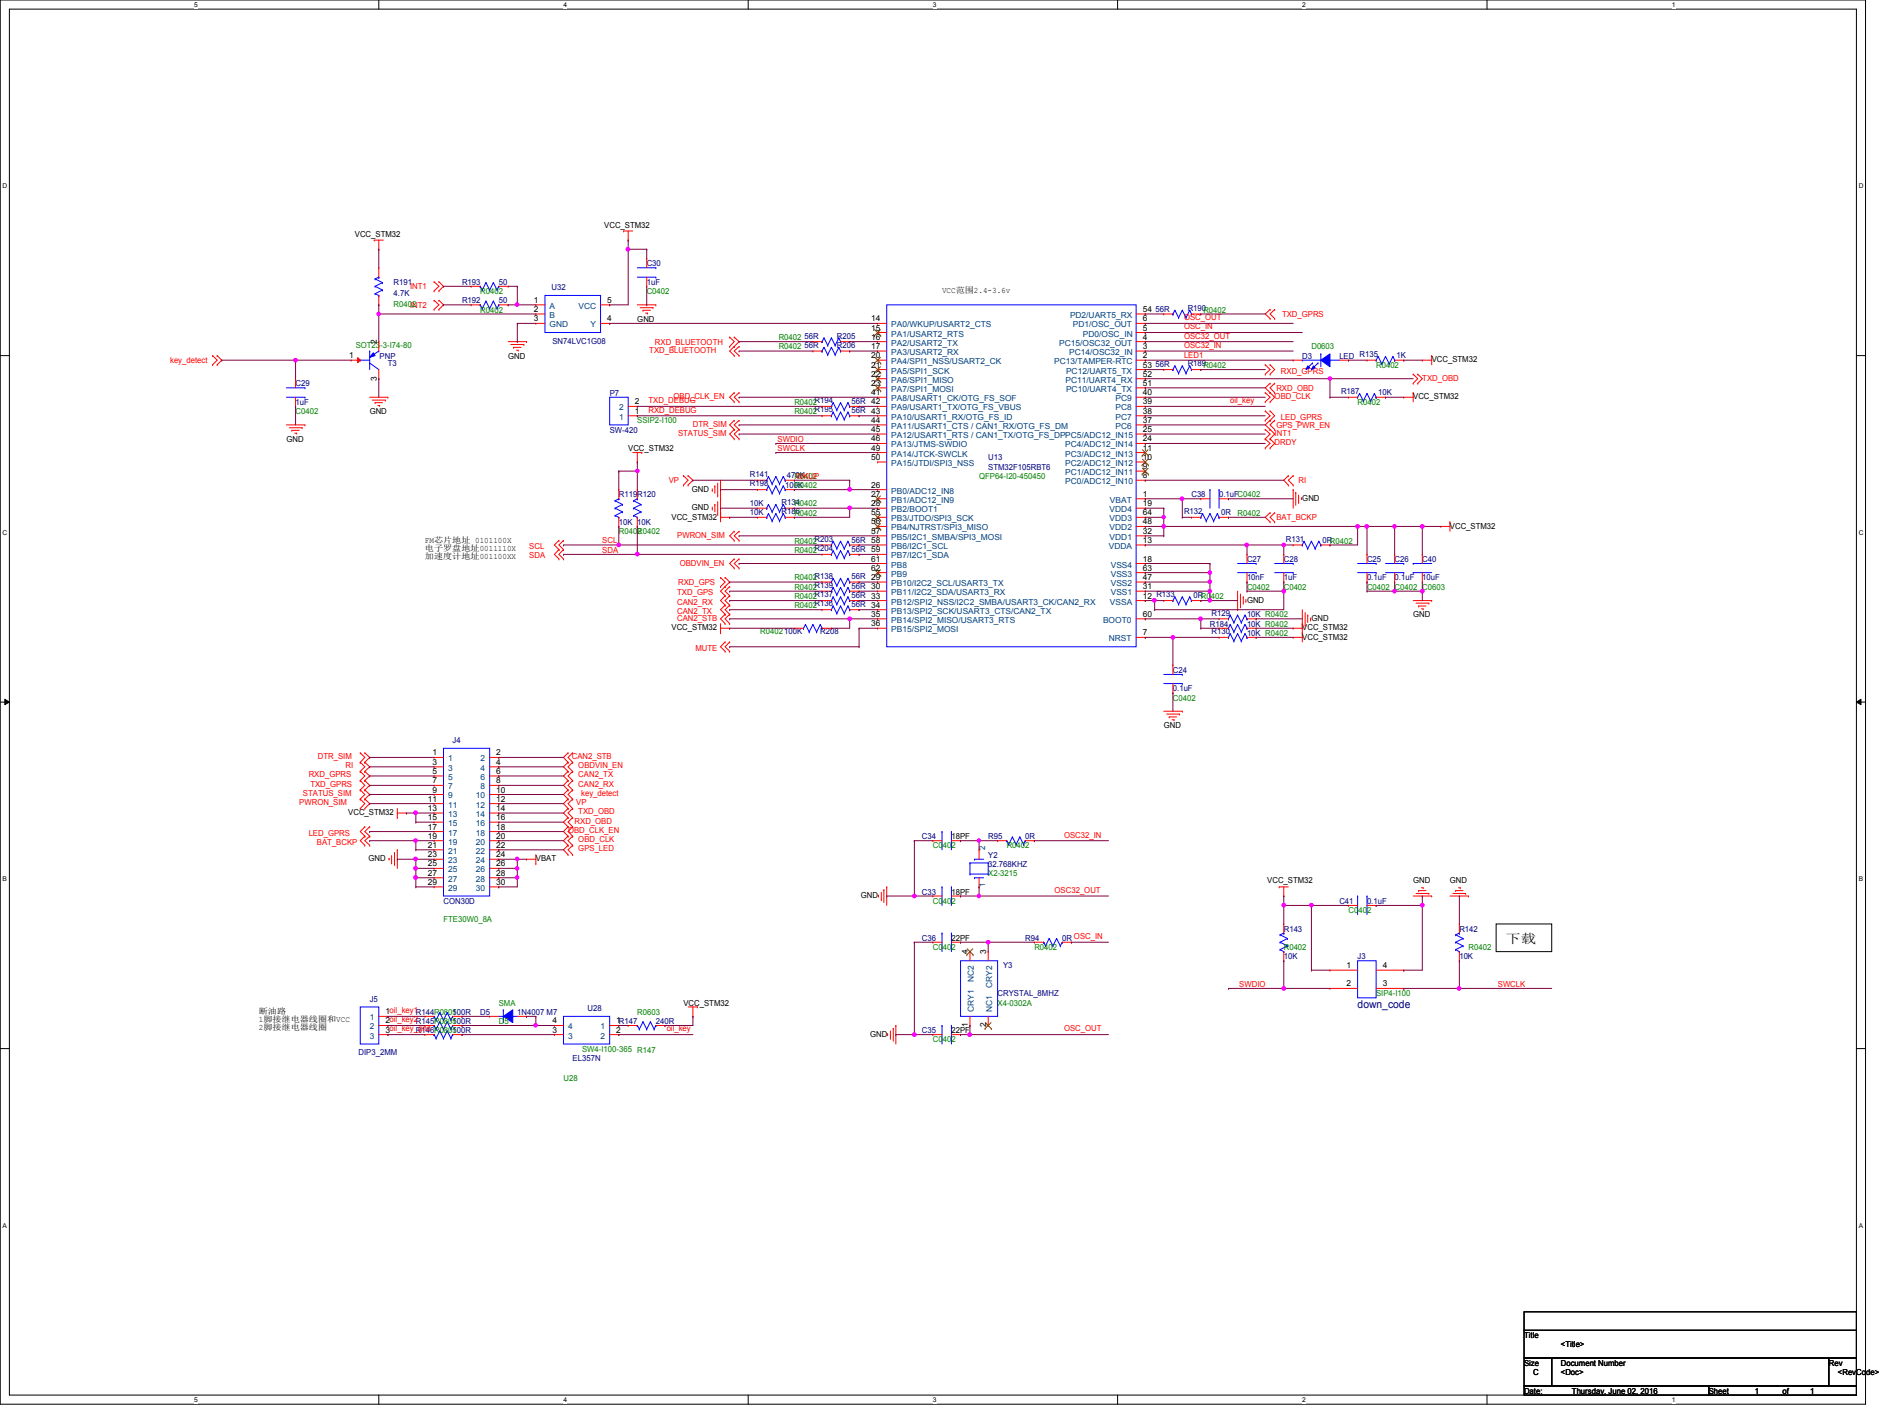
[picture p48: page 4]

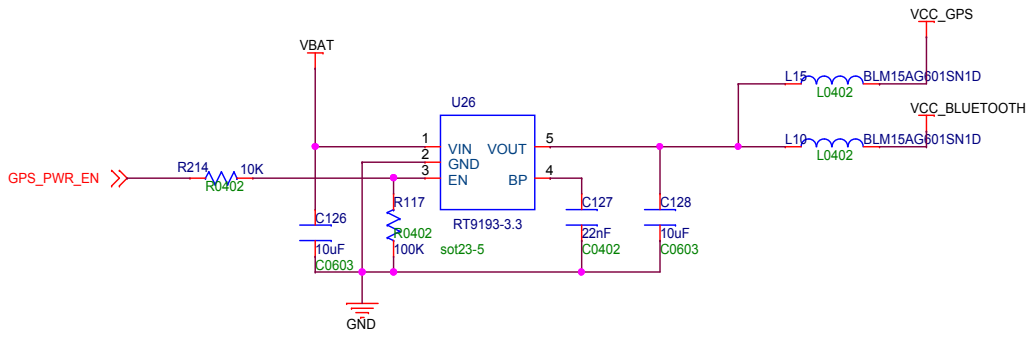
[picture p49: page 5]
