shenxiaofeng2019/rail-traffic_prj/(list of files, drawings)

Other design files:
Sensor/JY61资料包/AD封装/JY61.pcbdoc
